Szymon423/Air-Quality-Sensor/01_Hardware/README.md

# Hardware | Air Quality Sensor

| Folder | Contents |
|---|---|
| [`02_KiCad/air-quality-sensor`](02_KiCad/air-quality-sensor) | KiCad 10 project: schematic sheets (`mcu`, `sensors`, `led-ring`, `power-section`) and PCB |
| [`02_KiCad/air-quality-sensor/production`](02_KiCad/air-quality-sensor/production) | JLCPCB fabrication output: Gerbers, BOM, pick & place |
| [`02_KiCad/lib`](02_KiCad/lib) | Project-specific libraries and 3D models |
| [`03_3D_Model/3D-Printing`](03_3D_Model/3D-Printing) | Enclosure parts for 3D printing |

A PDF of the schematic is in [`docs/schematic.pdf`](../docs/schematic.pdf).

Licensed under [CC BY-NC-SA 4.0](../LICENSE).
