Szymon423/Air-Quality-Sensor/02_Software/README.md

# Software | Air Quality Sensor

🚧 Firmware for the ESP32-S3 is not written yet.

Planned:
- Readout of SCD41 (CO₂), SHT4x (temperature / humidity) and SPA06-003 (pressure) over I²C
- Air-quality indication on the 16× WS2812 LED ring
- Wi-Fi connectivity and Home Assistant integration (ESPHome / MQTT)

Licensed under [GPL-3.0](LICENSE).
