Szymon423/Air-Quality-Sensor/docs/images/pcb-top.webp

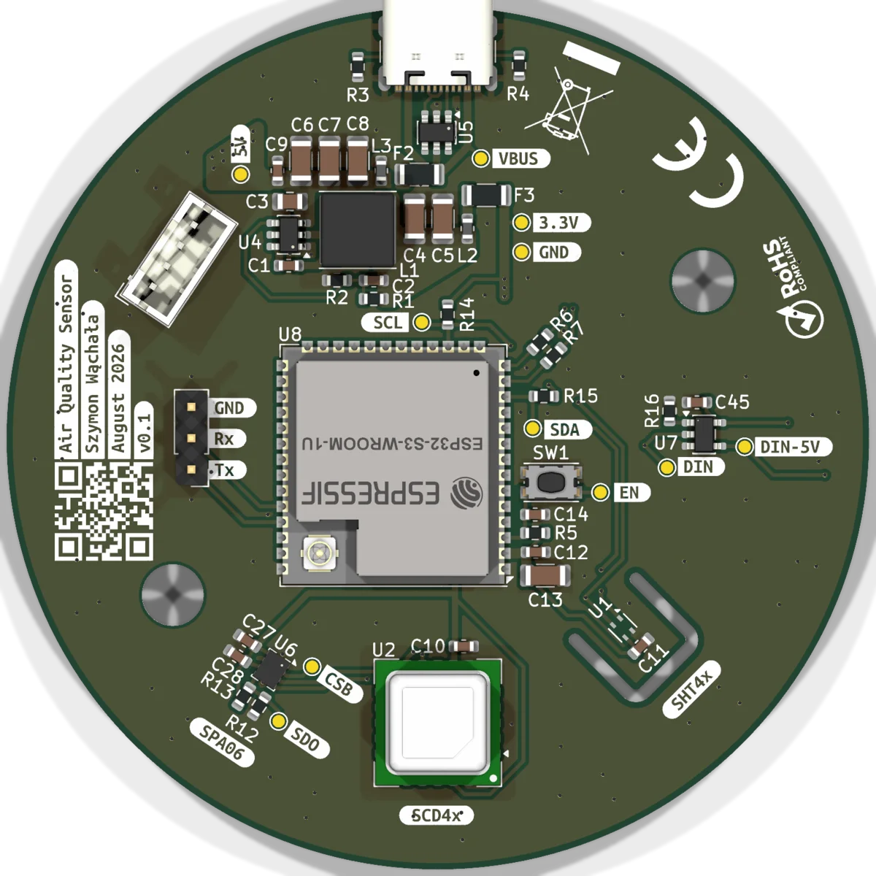
docs/images/pcb-top.webp
