Szymon423/Air-Quality-Sensor/01_Hardware/02_KiCad/air-quality-sensor/production/bom.csv

Designator | Footprint | Quantity | Value | LCSC Part #
C1, C10, C11, C12, C14, C27, C28, C29, C30, C31, C32, C33, C34, C35, C36, C37, C38, C39, C40, C41, C42, C43, C44, C45, C9 | 0603 | 25 | 100n | C14663
C13, C4, C5 | 1206 | 3 | 47u | C96123
C2 | 0603 | 1 | 82p | C1683
C3 | 0805 | 1 | 4.7u | C1779
C6, C7, C8 | 1206 | 3 | 10u | C13585
D10, D11, D12, D13, D14, D15, D16, D17, D18, D19, D4, D5, D6, D7, D8, D9 | LED_WS2812B-2020_PLCC4_2.0x2.0mm | 16 | WS2812C-2020 | C2976072
F2, F3 | 1206 | 2 | 1A | C561579
J1 | USB_C_Receptacle_GCT_USB4105-xx-A_16P_TopMnt_Horizontal | 1 | USB_C_Receptacle_USB2.0_16P | C3020560
L1 | L_APV_ANR6045 | 1 | 10u | C354632
L2, L3 | 0603 | 2 | L_Ferrite | C14709
R1 | 0603 | 1 | 100k | C25803
R13 | 0603 | 1 | 0R | C21189
R14, R15 | 0603 | 2 | 4.7k | C23162
R16 | 0603 | 1 | 0R
R2 | 0603 | 1 | 22k | C31850
R3, R4 | 0603 | 2 | 5.1k | C23186
R5 | 0603 | 1 | 10k | C22369937
R6, R7 | 0603 | 2 | 22R | C23345
SW1 | SW_Push_1P1T_NO_CK_KMR2 | 1 | SW_SPST | C72443
U1 | Sensirion_DFN-4_1.5x1.5mm_P0.8mm_SHT4x_NoCentralPad | 1 | SHT4x | C7461862
U2 | Sensirion_SCD4x-1EP_10.1x10.1mm_P1.25mm_EP4.8x4.8mm | 1 | SCD41-D-R2 | C3037696
U4 | SOT-23-6 | 1 | TPS54302 | C129370
U5 | SOT-23-6 | 1 | USBLC6-2SC6 | C558442
U6 | Bosch_LGA-8_2x2.5mm_P0.65mm_ClockwisePinNumbering | 1 | SPA06-003 | C30589048
U7 | SOT-23-5 | 1 | 74AHCT1G125 | C52140417
U8 | ESP32-S3-WROOM-1U | 1 | ESP32-S3-WROOM-1 | C2980297
