Szymon423/Air-Quality-Sensor/01_Hardware/03_3D_Model/3D-Printing/top.stl

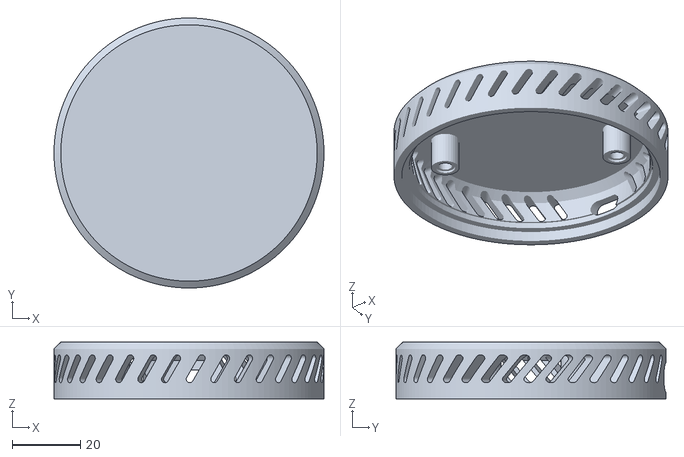
[picture p7: CAD file, 2026-10-19]
01_Hardware/03_3D_Model/3D-Printing/top.stl
79.3 x 79.3 x 16.7
