Szymon423/Air-Quality-Sensor/01_Hardware/03_3D_Model/3D-Printing/enclosure-test.3mf

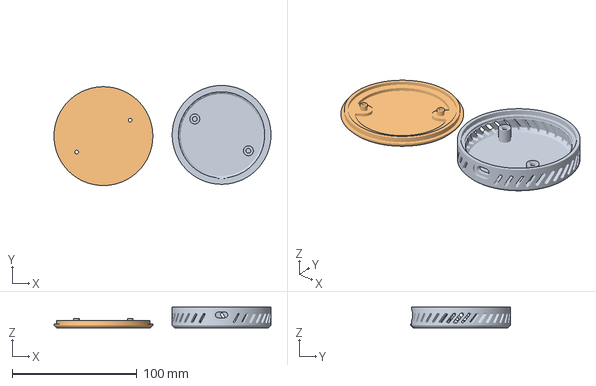
[picture p9: CAD file, 2026-10-19]
01_Hardware/03_3D_Model/3D-Printing/enclosure-test.3mf
174.1 x 80.3 x 16.7 mm
top.stl
btm.stl
