Szymon423/Air-Quality-Sensor/(list of files, cad)

Other CAD files:
01_Hardware/03_3D_Model/test.blend
