Szymon423/Air-Quality-Sensor/docs/schematic.pdf

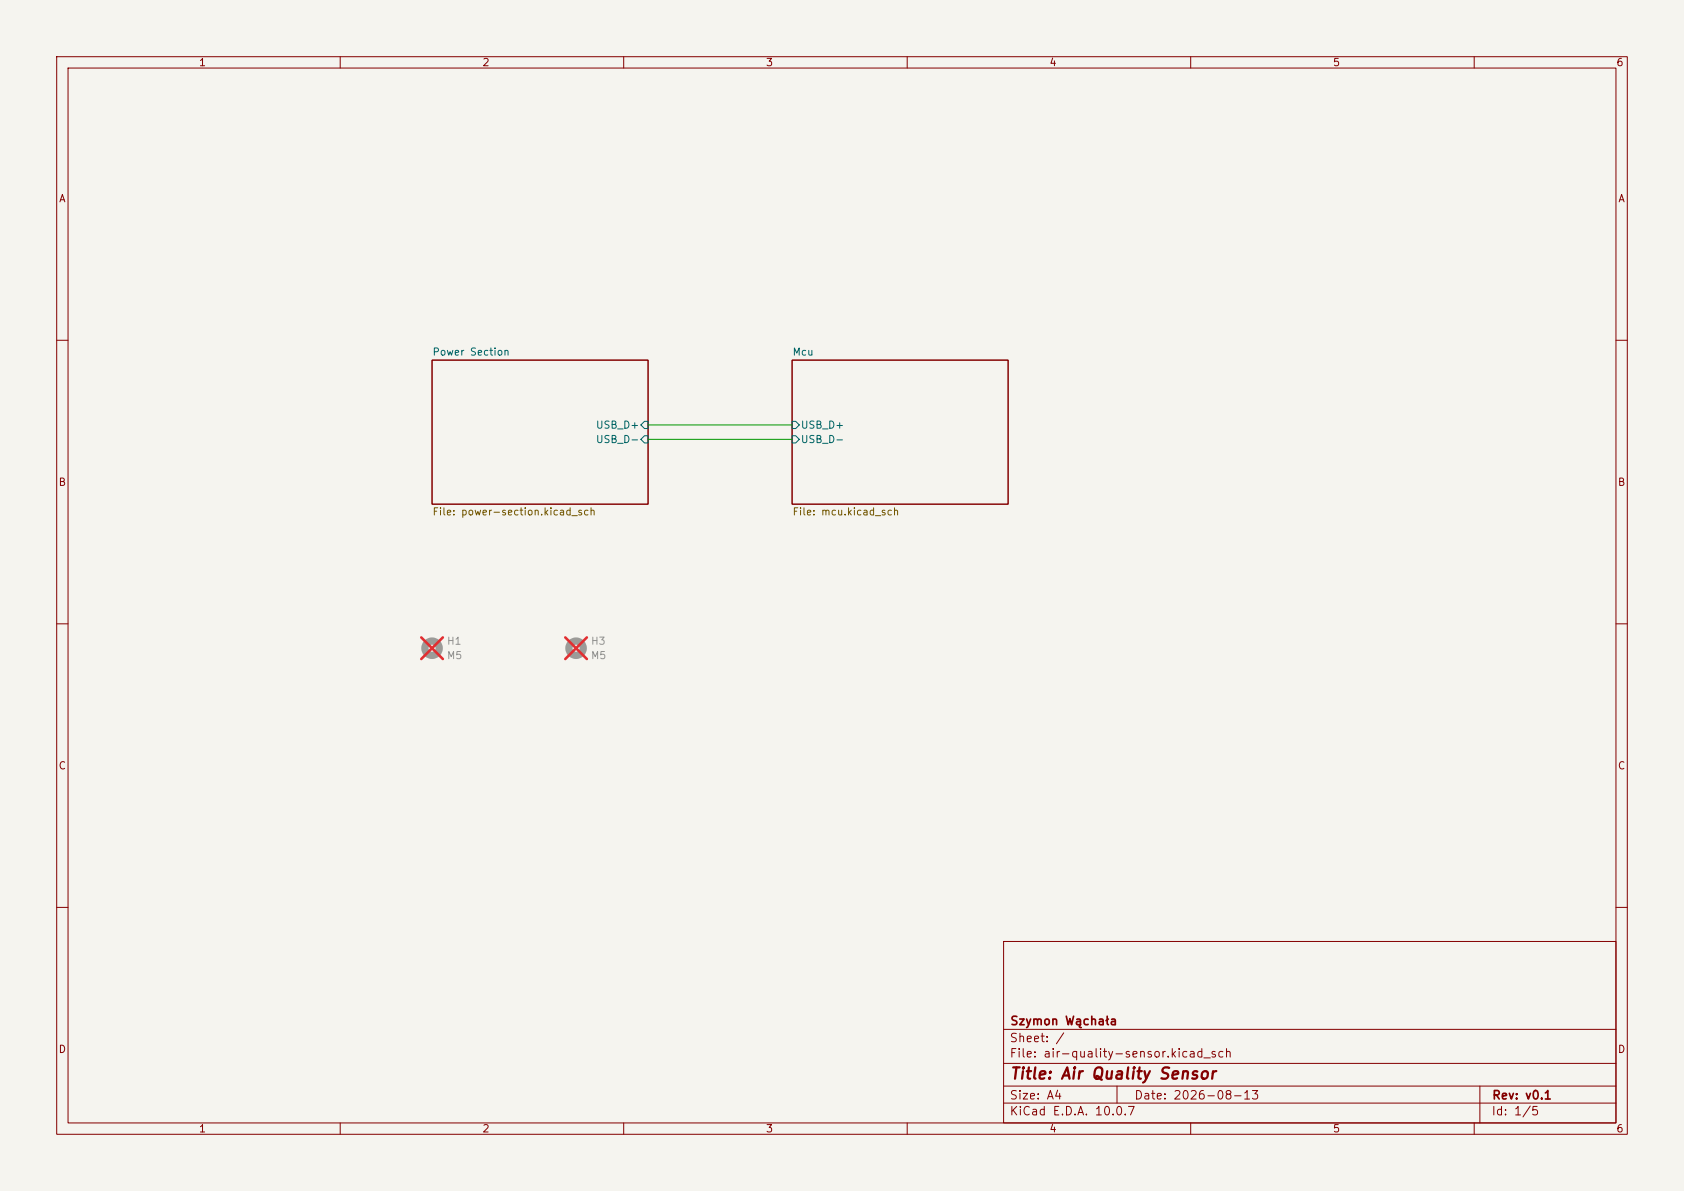
[picture p10: page 1]

Szymon Wąchała
Sheet: /
File: air-quality-sensor.kicad_sch
Title: Air Quality Sensor

Size: A4 | Rev: v0.1
KiCad E.D.A. 10.0.7 | Id: 1/5

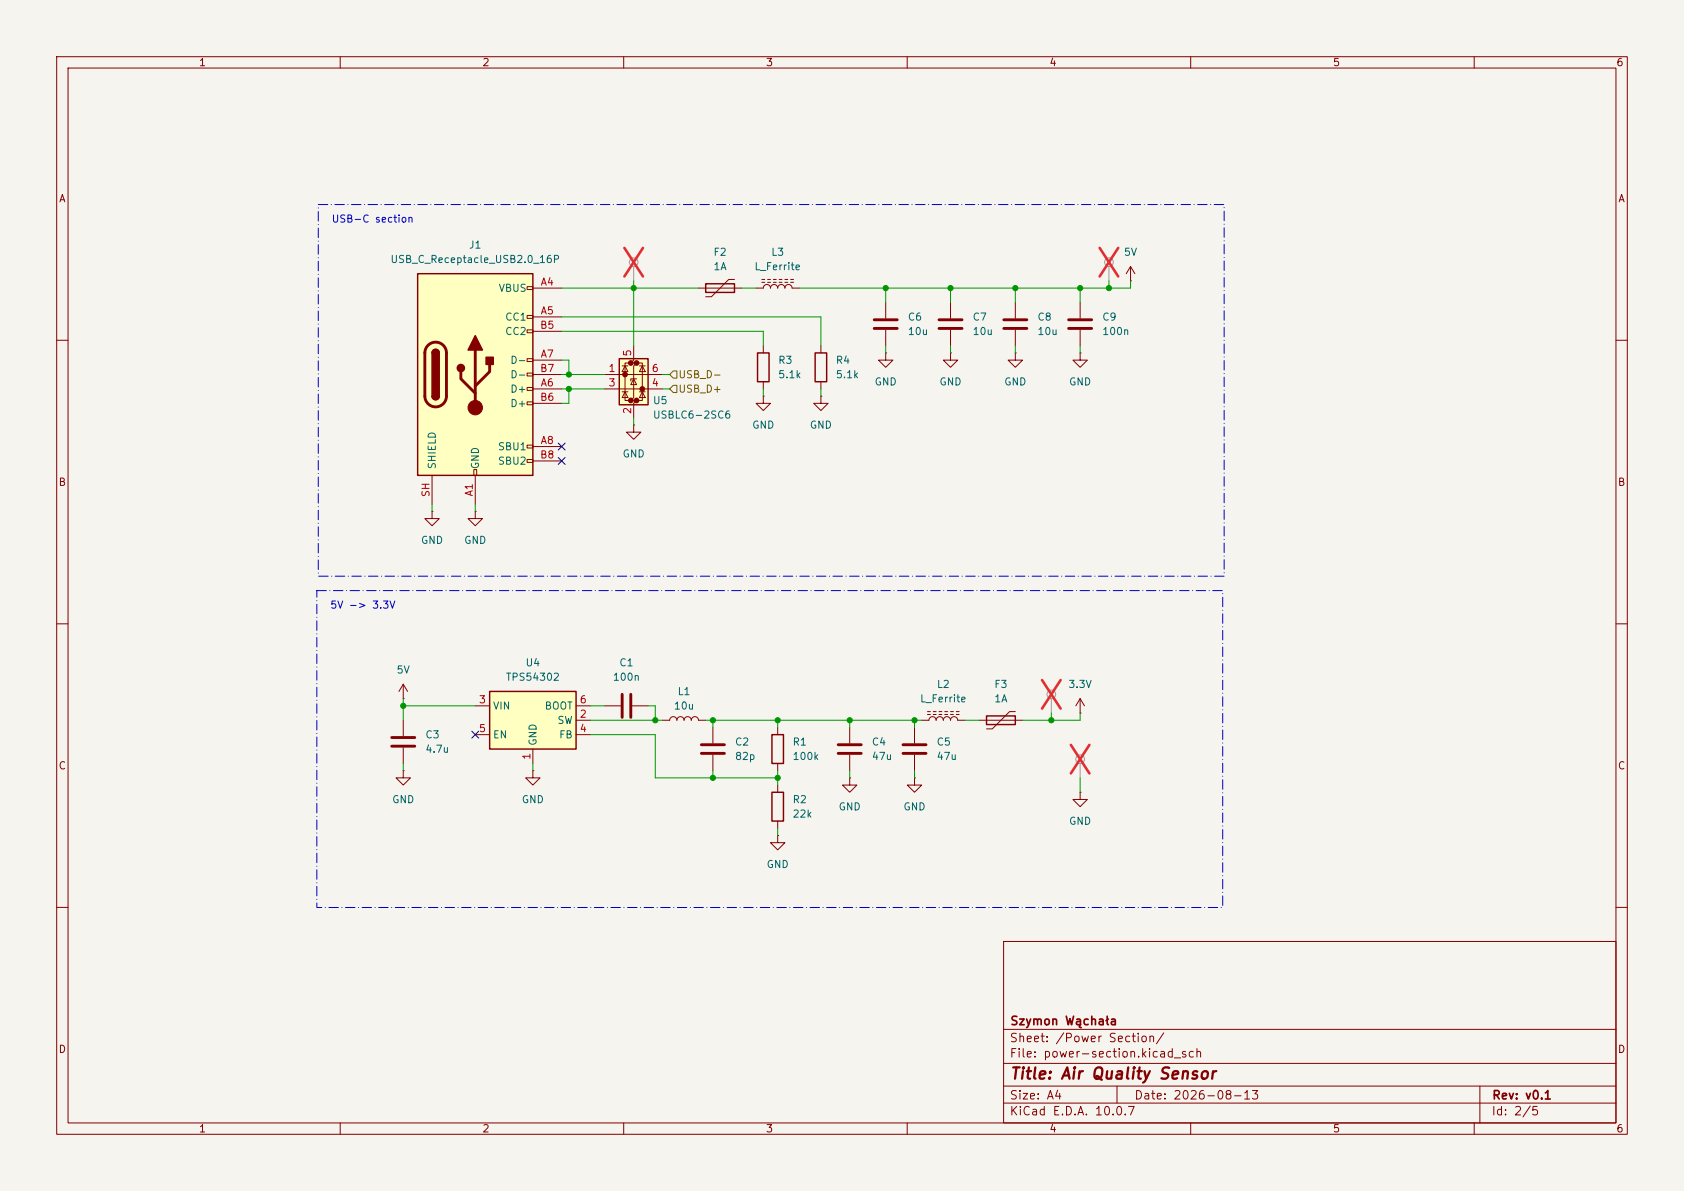
[picture p11: page 2]

Szymon Wąchała
Sheet: /Power Section/
File: power-section.kicad_sch
Title: Air Quality Sensor

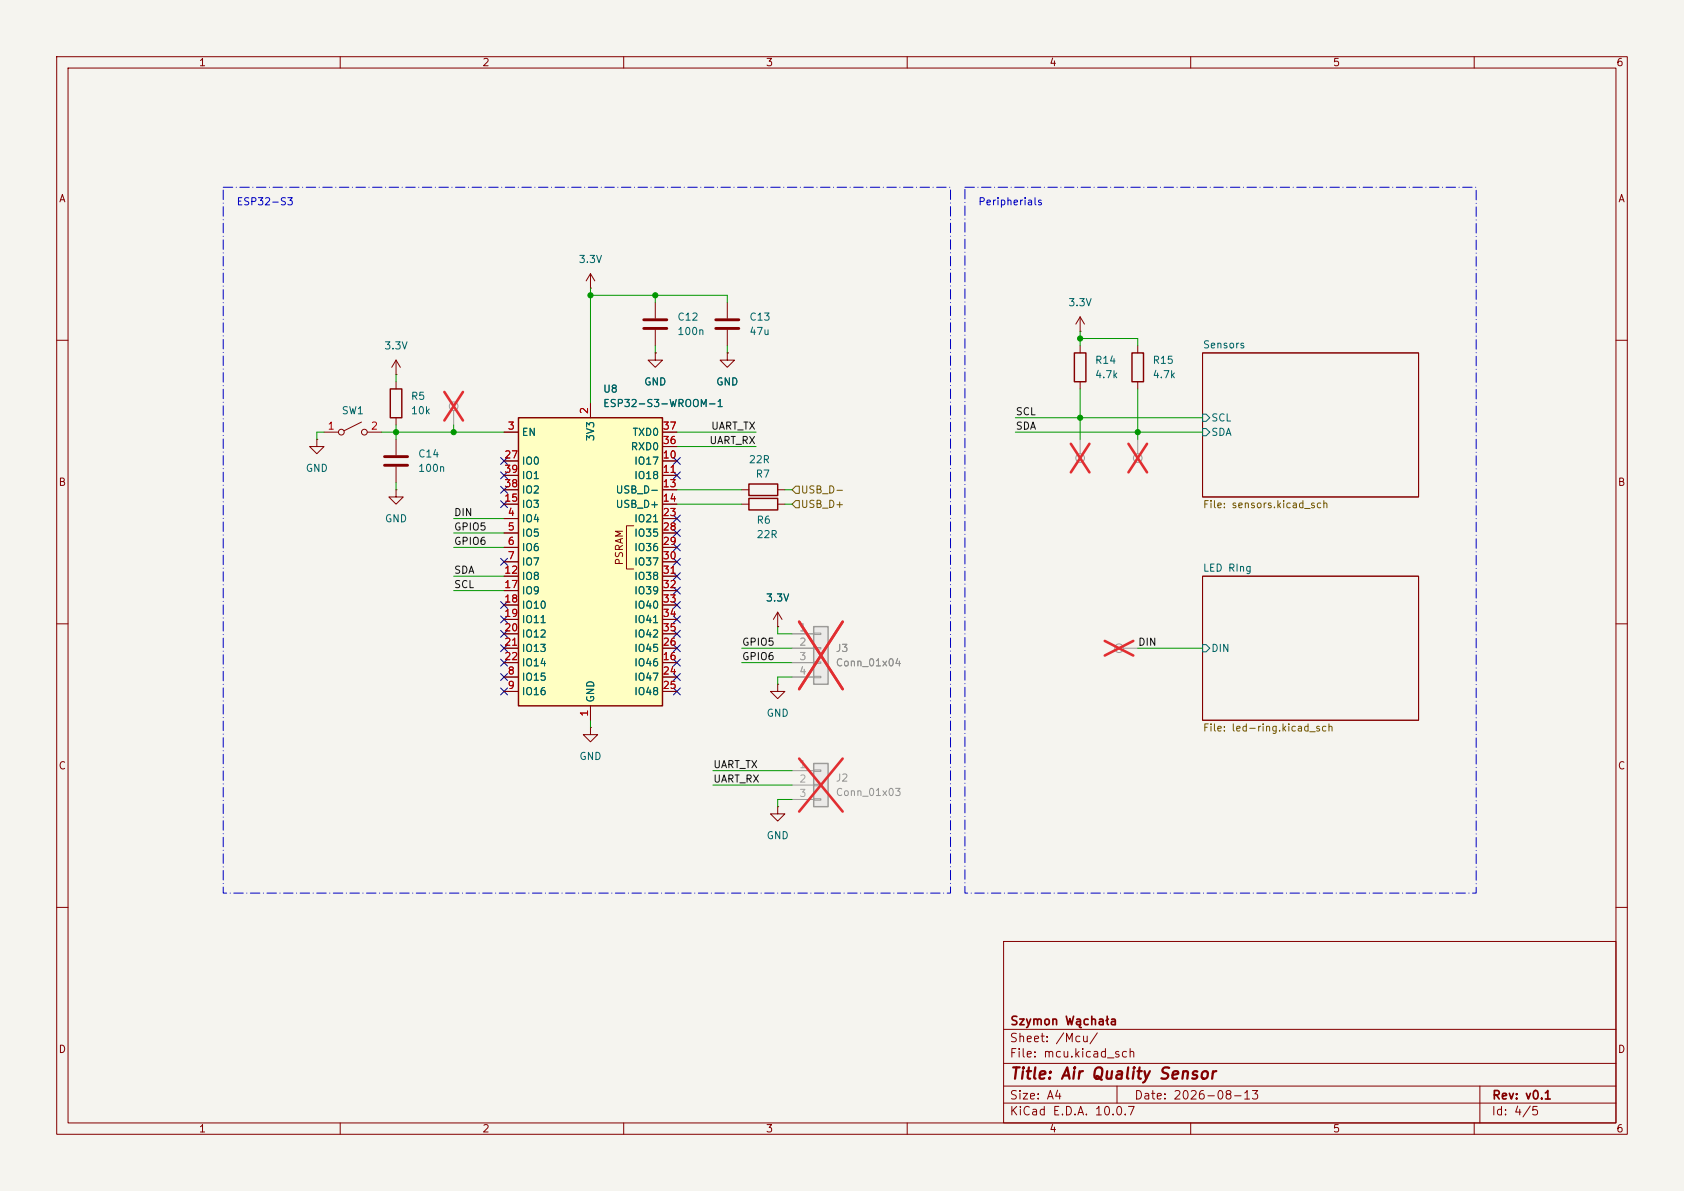
[picture p12: page 3]

File: led-ring.kicad_sch SCL SDA Sensors File: sensors.kicad_sch R6
IO42 35 RXD0 36 TXD0 37

Szymon Wąchała
Sheet: /Mcu/
File: mcu.kicad_sch
Title: Air Quality Sensor

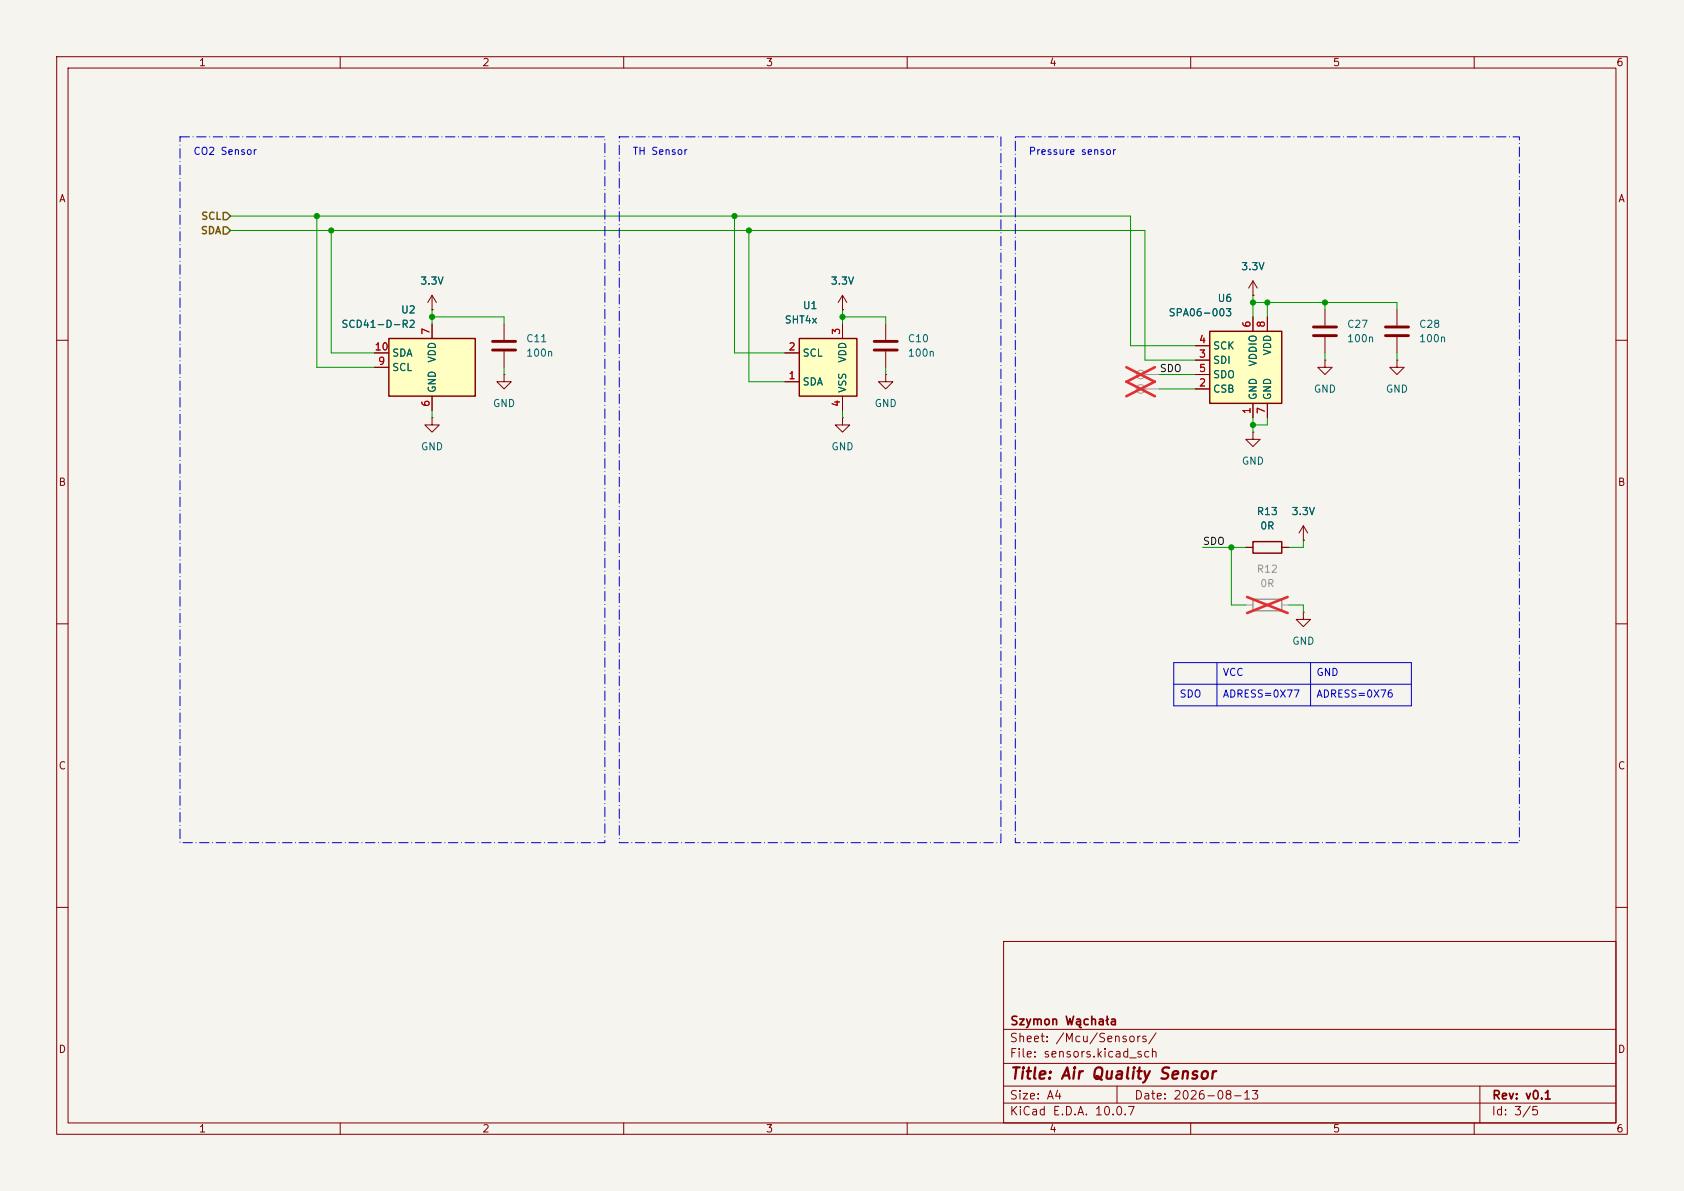
[picture p13: page 4]

VCC | GND

SDO | ADRESS=0X77 | ADRESS=0X76

Szymon Wąchała
Sheet: /Mcu/Sensors/
File: sensors.kicad_sch
Title: Air Quality Sensor

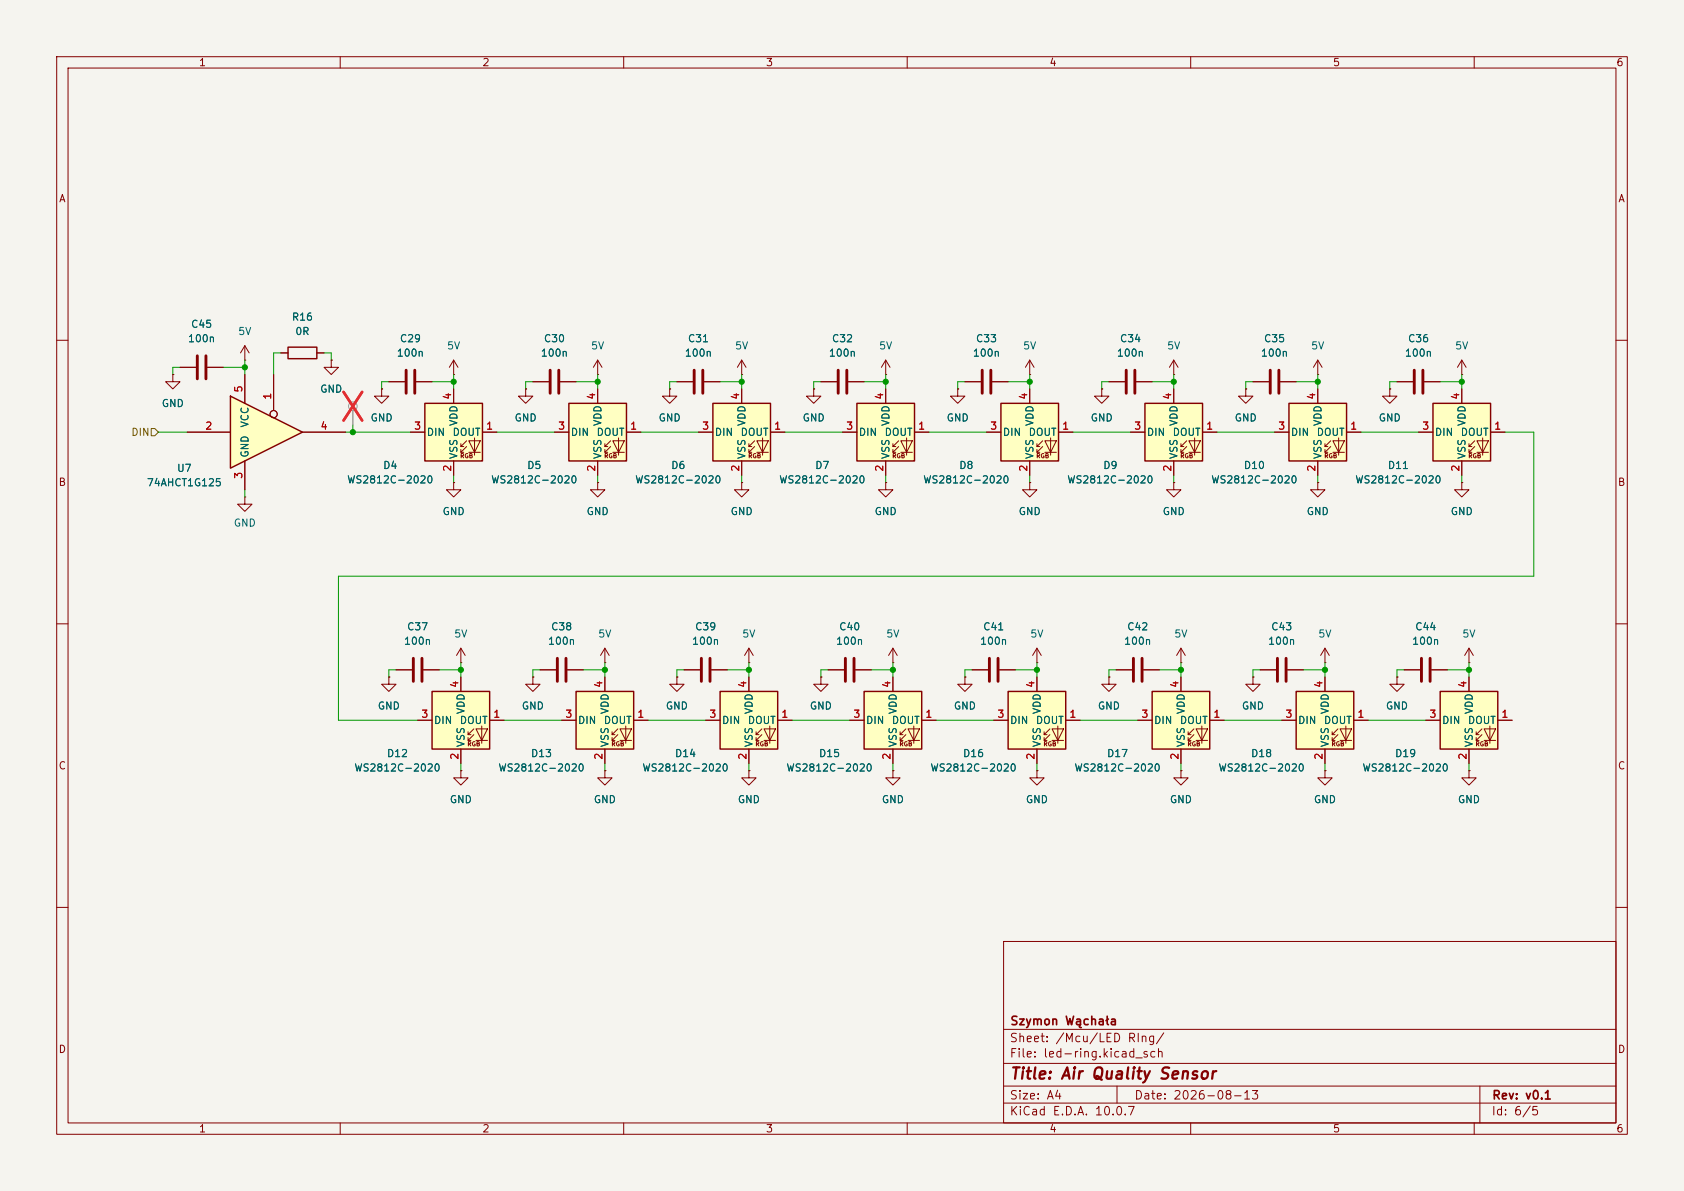
[picture p14: page 5]

Szymon Wąchała
Sheet: /Mcu/LED RIng/
File: led-ring.kicad_sch
Title: Air Quality Sensor
