Szymon423/Air-Quality-Sensor/01_Hardware/02_KiCad/air-quality-sensor/air-quality-sensor.kicad_pcb

## KiCad design 01_Hardware/02_KiCad/air-quality-sensor/air-quality-sensor.kicad_pcb (2026-08-15)

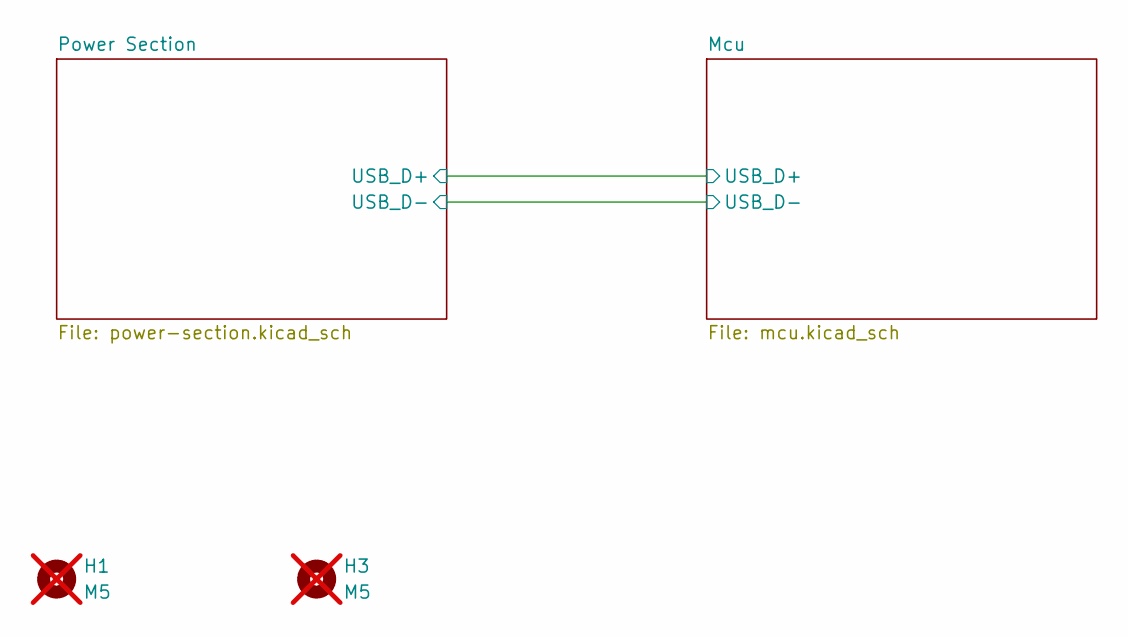
[picture p15: schematic air-quality-sensor.kicad_sch, Air Quality Sensor]

Parts:
H1, H3: M5; MountingHole_5mm; not fitted

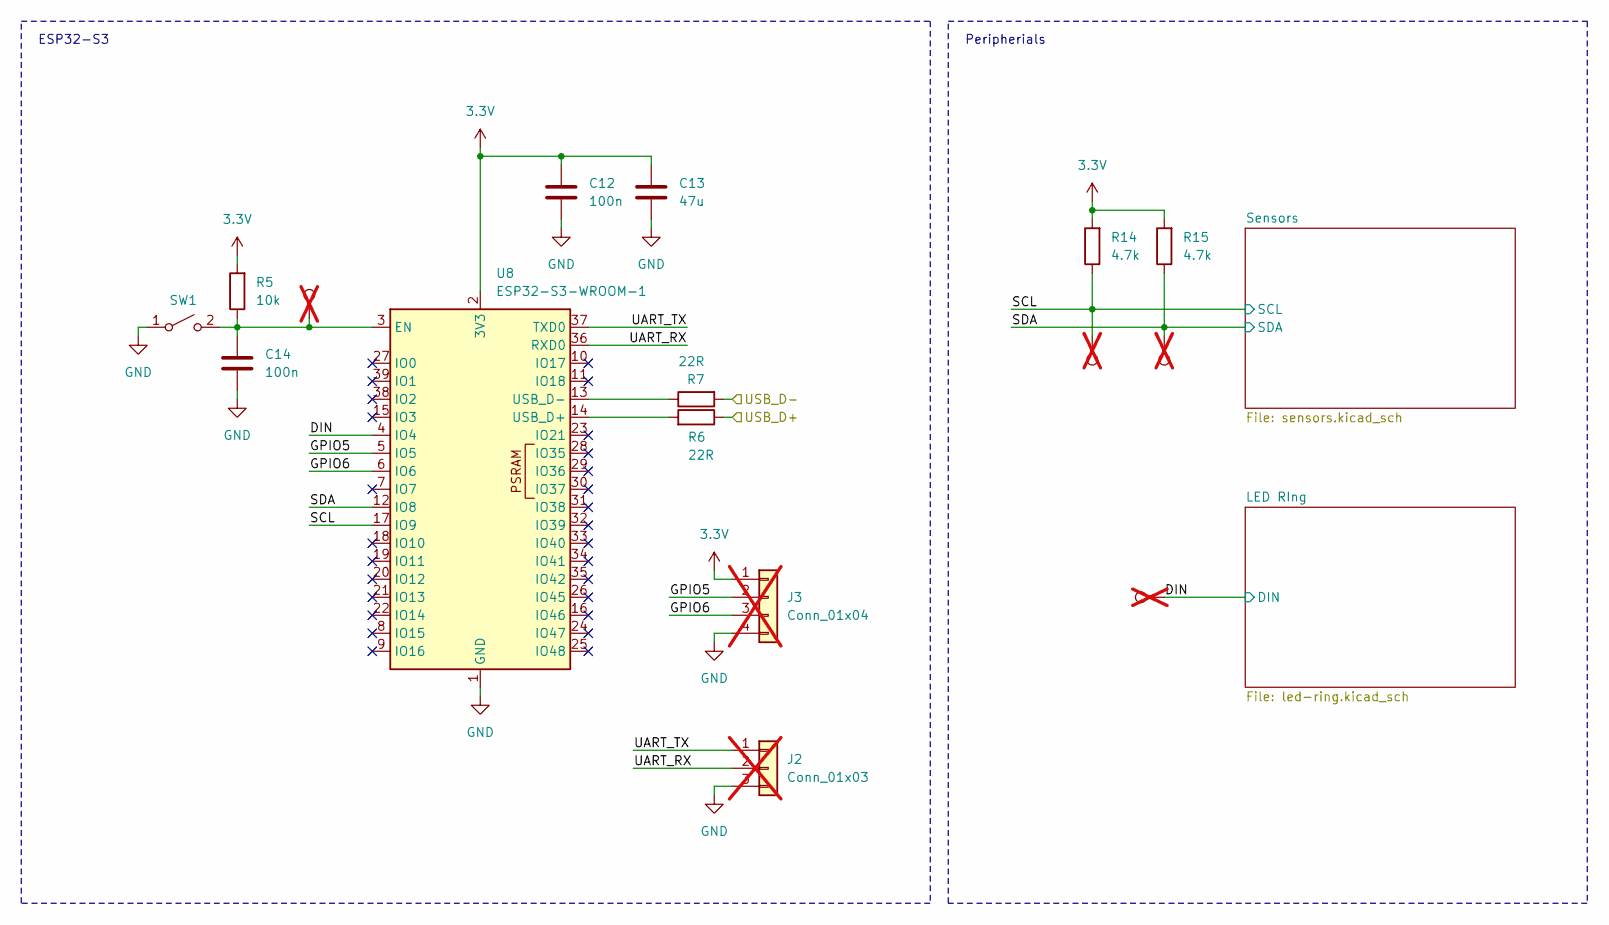
[picture p16: schematic mcu.kicad_sch, Air Quality Sensor]

Parts:
C12, C14: 100n; C_0603_1608Metric; LCSC C14663
C13: 47u; C_1206_3216Metric; LCSC C96123
J2: Conn_01x03; PinHeader_1x03_P2.54mm_Vertical; not fitted
J3: Conn_01x04; JST_PH_B4B-PH-K_1x04_P2.00mm_Vertical; not fitted
R5: 10k; R_0603_1608Metric; LCSC C22369937
R6, R7: 22R; R_0603_1608Metric; LCSC C23345
R14, R15: 4.7k; R_0603_1608Metric; LCSC C23162
SW1: SW_SPST; SW_Push_1P1T_NO_CK_KMR2; LCSC C72443
TP4, TP5, TP6, TP9: 3.3V; TestPoint_Pad_D1.0mm; not fitted
U8: ESP32-S3-WROOM-1; ESP32-S3-WROOM-1U; LCSC C2980297

Connections:
3.3V: C12.2, C13.1, J3.1, R5.2, R14.2, R15.2, U8.2 (3V3); also elsewhere on the board
/Mcu/DIN: TP9.1 (1_1), U8.4 (IO4); also elsewhere on the board
/Mcu/GPIO5: J3.2, U8.5 (IO5)
/Mcu/GPIO6: J3.3, U8.6 (IO6)
/Mcu/SCL: R14.1, TP5.1 (1_1), U8.17 (IO9); also elsewhere on the board
/Mcu/SDA: R15.1, TP4.1 (1_1), U8.12 (IO8); also elsewhere on the board
/Mcu/UART_RX: J2.2, U8.36 (RXD0)
/Mcu/UART_TX: J2.1, U8.37 (TXD0)
/Mcu/USB_D+: R6.1; also elsewhere on the board
/Mcu/USB_D-: R7.2; also elsewhere on the board
GND: C12.1, C13.2, C14.1, J2.3, J3.4, SW1.1 (A), U8.1 (GND), U8.40 (GND), U8.41 (GND); also elsewhere on the board
unnamed: C14.2, R5.1, SW1.2 (B), TP6.1 (1_1), U8.3 (EN)
unnamed: R6.2, U8.14 (USB_D+)
unnamed: R7.1, U8.13 (USB_D-)

Notes on the sheet:
ESP32-S3
Peripherials

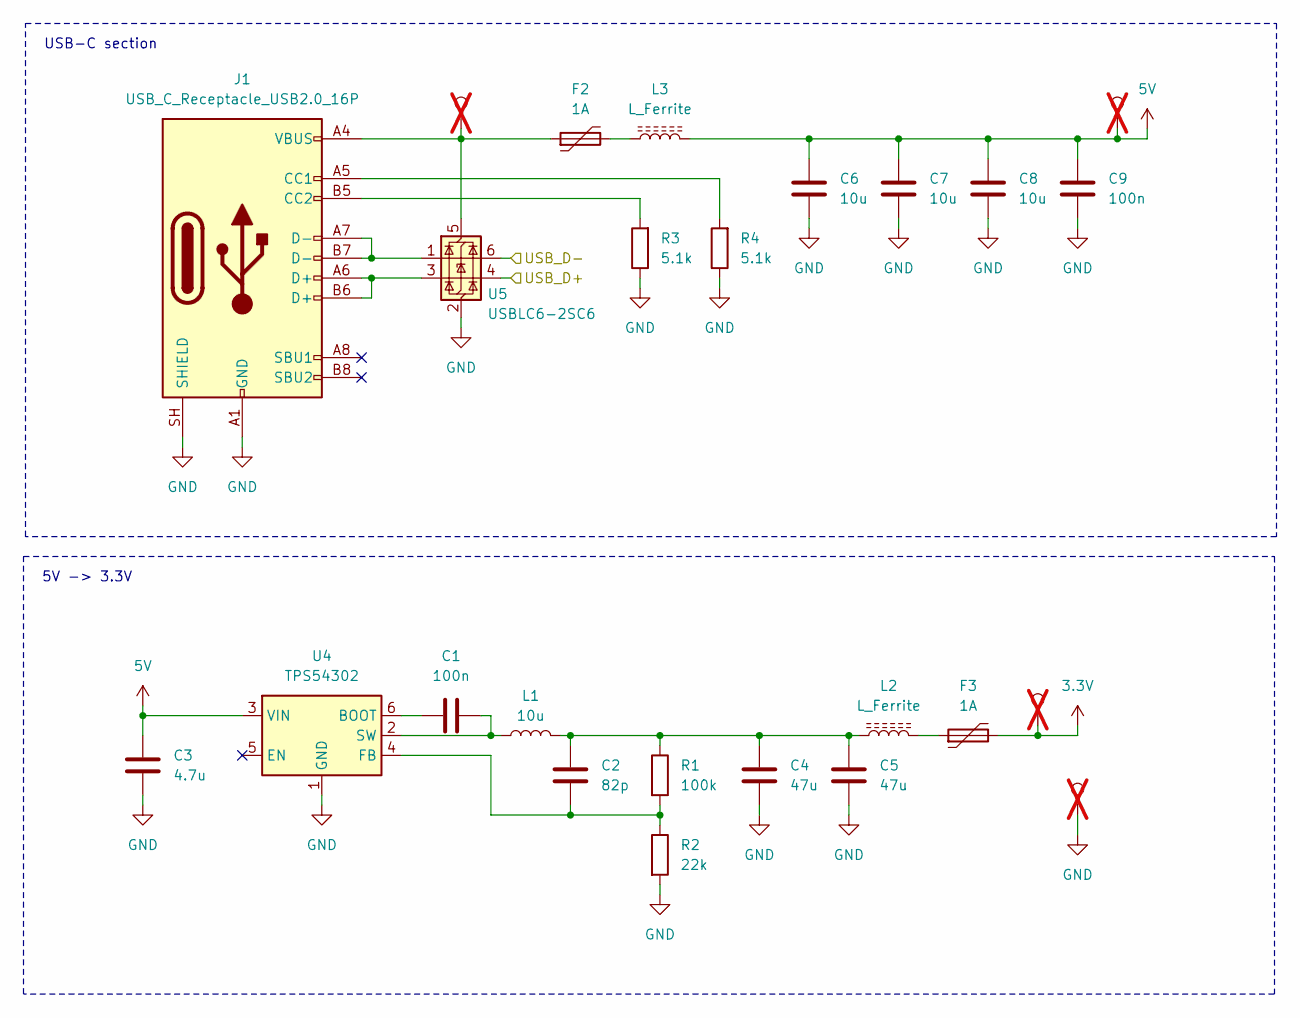
[picture p17: schematic power-section.kicad_sch, Air Quality Sensor]

Parts:
C1, C9: 100n; C_0603_1608Metric; LCSC C14663
C2: 82p; C_0603_1608Metric; LCSC C1683
C3: 4.7u; C_0805_2012Metric; LCSC C1779
C4, C5: 47u; C_1206_3216Metric; LCSC C96123
C6, C7, C8: 10u; C_1206_3216Metric; LCSC C13585
F2, F3: 1A; R_1206_3216Metric; LCSC C561579
J1: USB_C_Receptacle_USB2.0_16P; USB_C_Receptacle_GCT_USB4105-xx-A_16P_TopMnt_Horizontal; LCSC C3020560
L1: 10u; L_APV_ANR6045; LCSC C354632
L2, L3: L_Ferrite; L_0603_1608Metric; LCSC C14709
R1: 100k; R_0603_1608Metric; LCSC C25803
R2: 22k; R_0603_1608Metric; LCSC C31850
R3, R4: 5.1k; R_0603_1608Metric; LCSC C23186
TP1, TP2, TP3, TP10: 3.3V; TestPoint_Pad_D1.0mm; not fitted
U4: TPS54302; SOT-23-6; LCSC C129370
U5: USBLC6-2SC6; SOT-23-6; LCSC C558442

Connections:
3.3V: F3.2, TP1.1 (1_1); also elsewhere on the board
5V: C3.1, C6.1, C7.1, C8.1, C9.2, L3.2, TP2.1 (1_1), U4.3 (VIN); also elsewhere on the board
/Mcu/USB_D+: U5.4 (I/O2); also elsewhere on the board
/Mcu/USB_D-: U5.6 (I/O1); also elsewhere on the board
GND: C3.2, C4.2, C5.2, C6.2, C7.2, C8.2, C9.1, J1.A1 (GND), J1.A12 (GND), J1.B1 (GND), J1.B12 (GND), J1.SH (SHIELD), R2.2, R3.1, R4.1, TP10.1 (1_1), U4.1 (GND), U5.2 (GND); also elsewhere on the board
unnamed: C2.2, C4.1, C5.1, L1.2, L2.1, R1.1
unnamed: F2.2, L3.1
unnamed: F3.1, L2.2
unnamed: J1.A5 (CC1), R4.2
unnamed: J1.B5 (CC2), R3.2
unnamed: J1.A6 (D+), J1.B6 (D+), U5.3 (I/O2)
unnamed: J1.A7 (D-), J1.B7 (D-), U5.1 (I/O1)
unnamed: C1.1, U4.6 (BOOT)
unnamed: C2.1, R1.2, R2.1, U4.4 (FB)
unnamed: C1.2, L1.1, U4.2 (SW)
unnamed: F2.1, J1.A4 (VBUS), J1.A9 (VBUS), J1.B4 (VBUS), J1.B9 (VBUS), TP3.1 (1_1), U5.5 (VBUS)

Notes on the sheet:
5V -> 3.3V
USB-C section

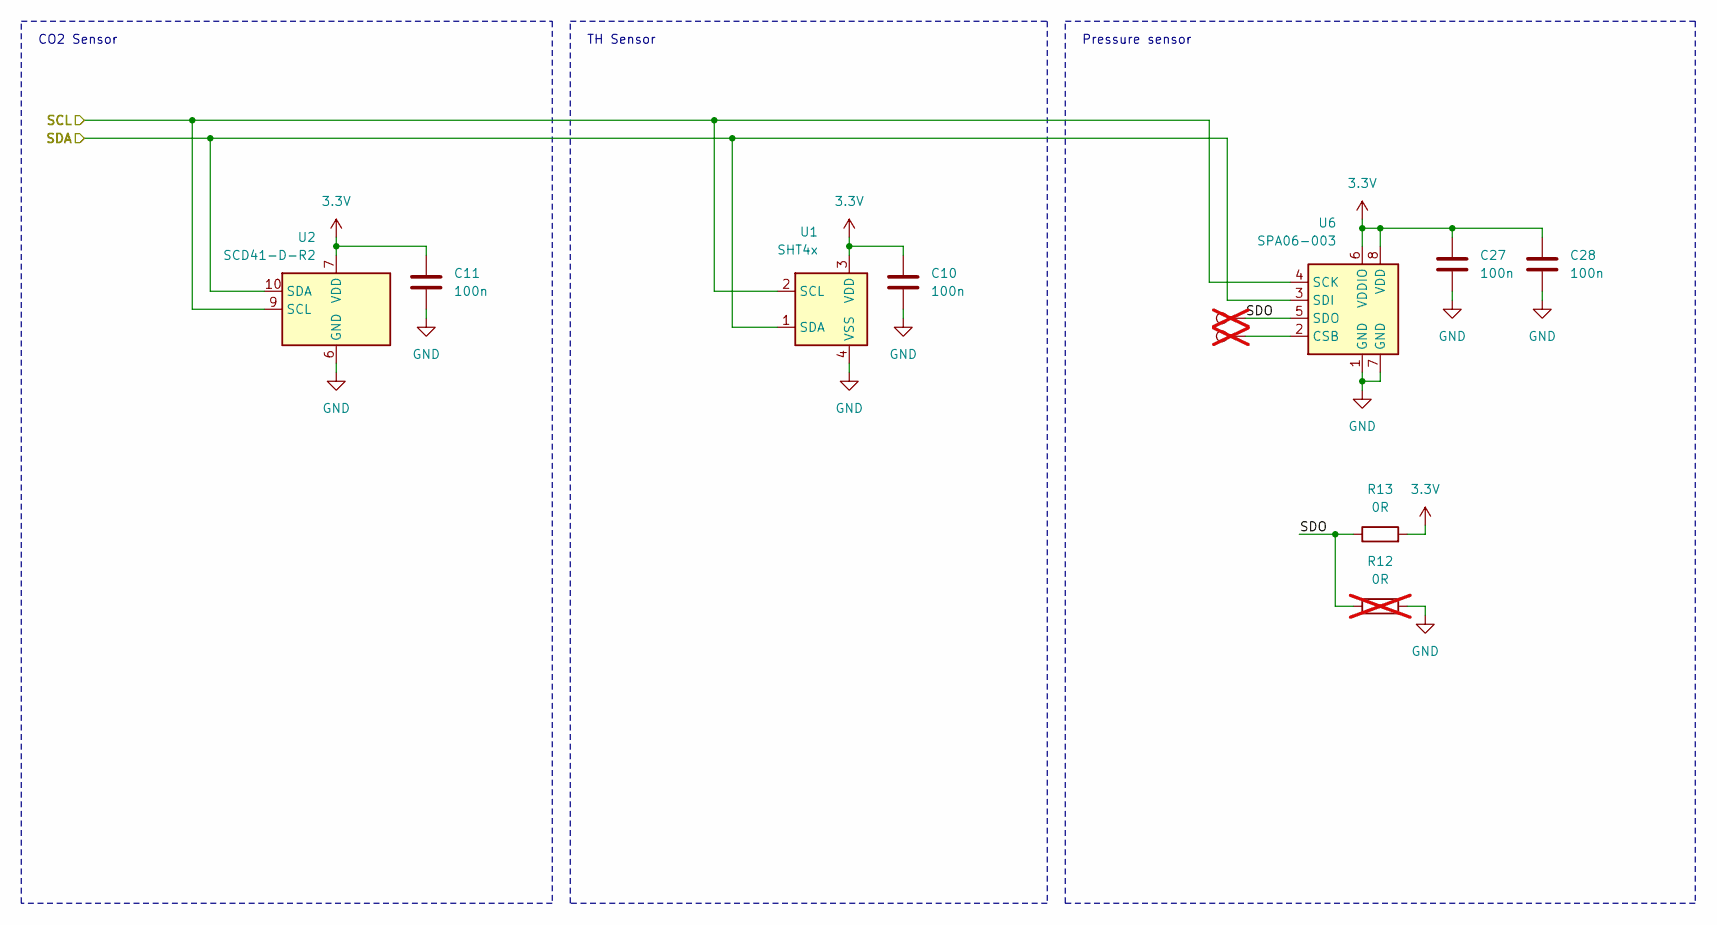
[picture p18: schematic sensors.kicad_sch, Air Quality Sensor]

Parts:
C10, C11, C27, C28: 100n; C_0603_1608Metric; LCSC C14663
R12: 0R; R_0603_1608Metric; LCSC C21189; not fitted
R13: 0R; R_0603_1608Metric; LCSC C21189
TP7, TP8: 3.3V; TestPoint_Pad_D1.0mm; not fitted
U1: SHT4x; Sensirion_DFN-4_1.5x1.5mm_P0.8mm_SHT4x_NoCentralPad; LCSC C7461862
U2: SCD41-D-R2; Sensirion_SCD4x-1EP_10.1x10.1mm_P1.25mm_EP4.8x4.8mm; LCSC C3037696
U6: SPA06-003; Bosch_LGA-8_2x2.5mm_P0.65mm_ClockwisePinNumbering; LCSC C30589048

Connections:
3.3V: C10.2, C11.2, C27.1, C28.1, R13.2, U1.3 (VDD), U2.7 (VDD), U2.19 (VDD), U6.6 (VDDIO), U6.8 (VDD); also elsewhere on the board
/Mcu/SCL: U1.2 (SCL), U2.9 (SCL), U6.4 (SCK); also elsewhere on the board
/Mcu/SDA: U1.1 (SDA), U2.10 (SDA), U6.3 (SDI); also elsewhere on the board
/Mcu/Sensors/SDO: R12.1, R13.1, TP7.1 (1_1), U6.5 (SDO)
GND: C10.1, C11.1, C27.2, C28.2, R12.2, U1.4 (VSS), U2.6 (GND), U2.20 (GND), U2.21 (GND), U6.1 (GND), U6.7 (GND); also elsewhere on the board
unnamed: TP8.1 (1_1), U6.2 (CSB)

Notes on the sheet:
TH Sensor
CO2 Sensor
Pressure sensor

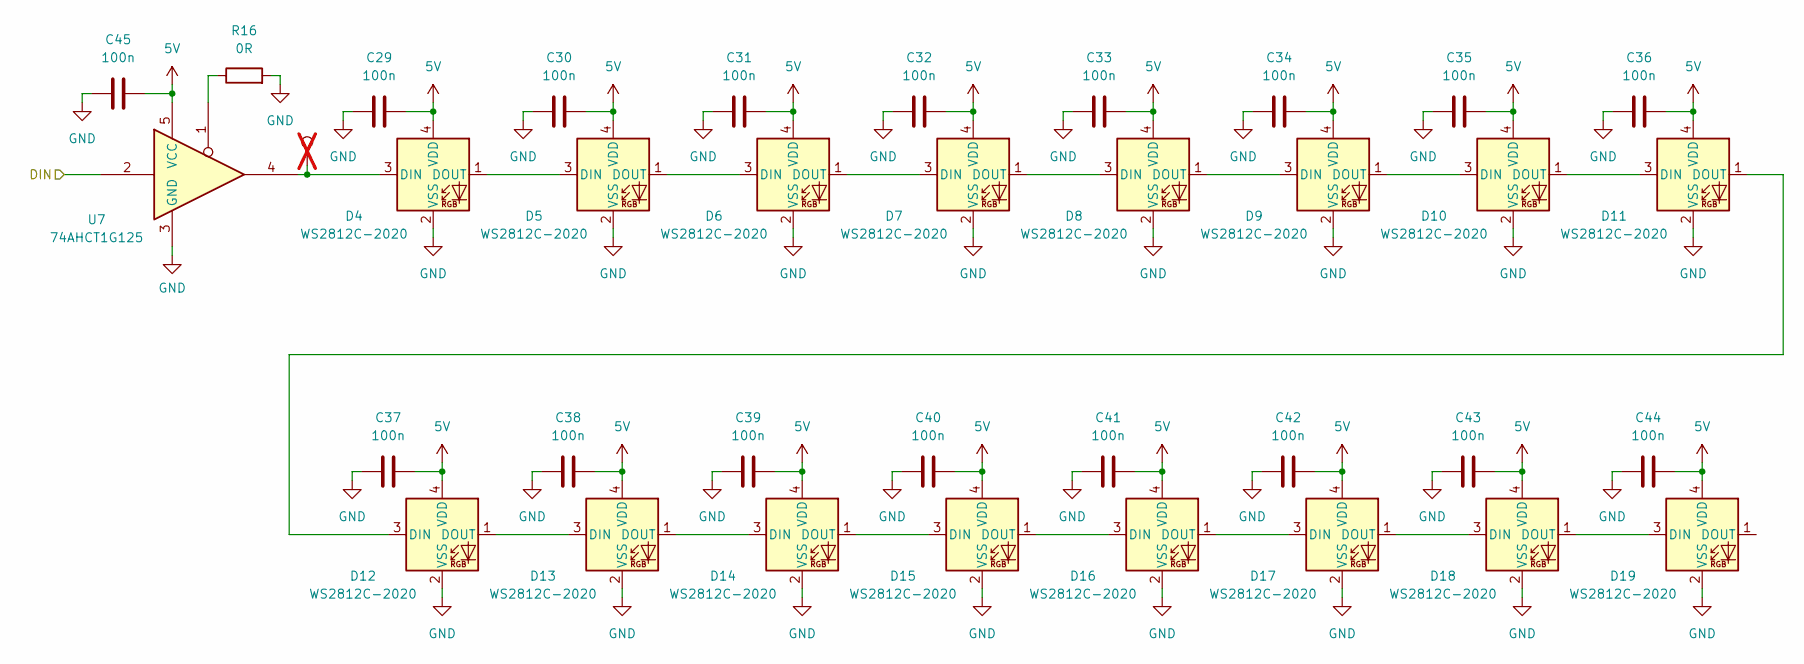
[picture p19: schematic led-ring.kicad_sch, Air Quality Sensor]

Parts:
C29, C30, C31, C32, C33, C34, C35, C36, C37, C38, C39, C40, C41, C42, C43, C44, C45: 100n; C_0603_1608Metric; LCSC C14663
D4, D5, D6, D7, D8, D9, D10, D11, D12, D13, D14, D15, D16, D17, D18, D19: WS2812C-2020; LED_WS2812B-2020_PLCC4_2.0x2.0mm; LCSC C2976072
R16: 0R; R_0603_1608Metric; LCSC C21189
TP19: 3.3V; TestPoint_Pad_D1.0mm; not fitted
U7: 74AHCT1G125; SOT-23-5; LCSC C52140417

Connections:
5V: C29.1, C30.1, C31.1, C32.1, C33.1, C34.1, C35.1, C36.1, C37.1, C38.1, C39.1, C40.1, C41.1, C42.1, C43.1, C44.1, C45.1, D4.4 (VDD), D5.4 (VDD), D6.4 (VDD), D7.4 (VDD), D8.4 (VDD), D9.4 (VDD), D10.4 (VDD), D11.4 (VDD), D12.4 (VDD), D13.4 (VDD), D14.4 (VDD), D15.4 (VDD), D16.4 (VDD), D17.4 (VDD), D18.4 (VDD), D19.4 (VDD), U7.5 (VCC); also elsewhere on the board
/Mcu/DIN: U7.2; also elsewhere on the board
GND: C29.2, C30.2, C31.2, C32.2, C33.2, C34.2, C35.2, C36.2, C37.2, C38.2, C39.2, C40.2, C41.2, C42.2, C43.2, C44.2, C45.2, D4.2 (VSS), D5.2 (VSS), D6.2 (VSS), D7.2 (VSS), D8.2 (VSS), D9.2 (VSS), D10.2 (VSS), D11.2 (VSS), D12.2 (VSS), D13.2 (VSS), D14.2 (VSS), D15.2 (VSS), D16.2 (VSS), D17.2 (VSS), D18.2 (VSS), D19.2 (VSS), R16.2, U7.3 (GND); also elsewhere on the board
unnamed: D4.3 (DIN), TP19.1 (1_1), U7.4
unnamed: D4.1 (DOUT), D5.3 (DIN)
unnamed: D5.1 (DOUT), D6.3 (DIN)
unnamed: D6.1 (DOUT), D7.3 (DIN)
unnamed: D7.1 (DOUT), D8.3 (DIN)
unnamed: D8.1 (DOUT), D9.3 (DIN)
unnamed: D9.1 (DOUT), D10.3 (DIN)
unnamed: D10.1 (DOUT), D11.3 (DIN)
unnamed: D11.1 (DOUT), D12.3 (DIN)
unnamed: D12.1 (DOUT), D13.3 (DIN)
unnamed: D13.1 (DOUT), D14.3 (DIN)
unnamed: D14.1 (DOUT), D15.3 (DIN)
unnamed: D15.1 (DOUT), D16.3 (DIN)
unnamed: D16.1 (DOUT), D17.3 (DIN)
unnamed: D17.1 (DOUT), D18.3 (DIN)
unnamed: D18.1 (DOUT), D19.3 (DIN)
unnamed: R16.1, U7.1

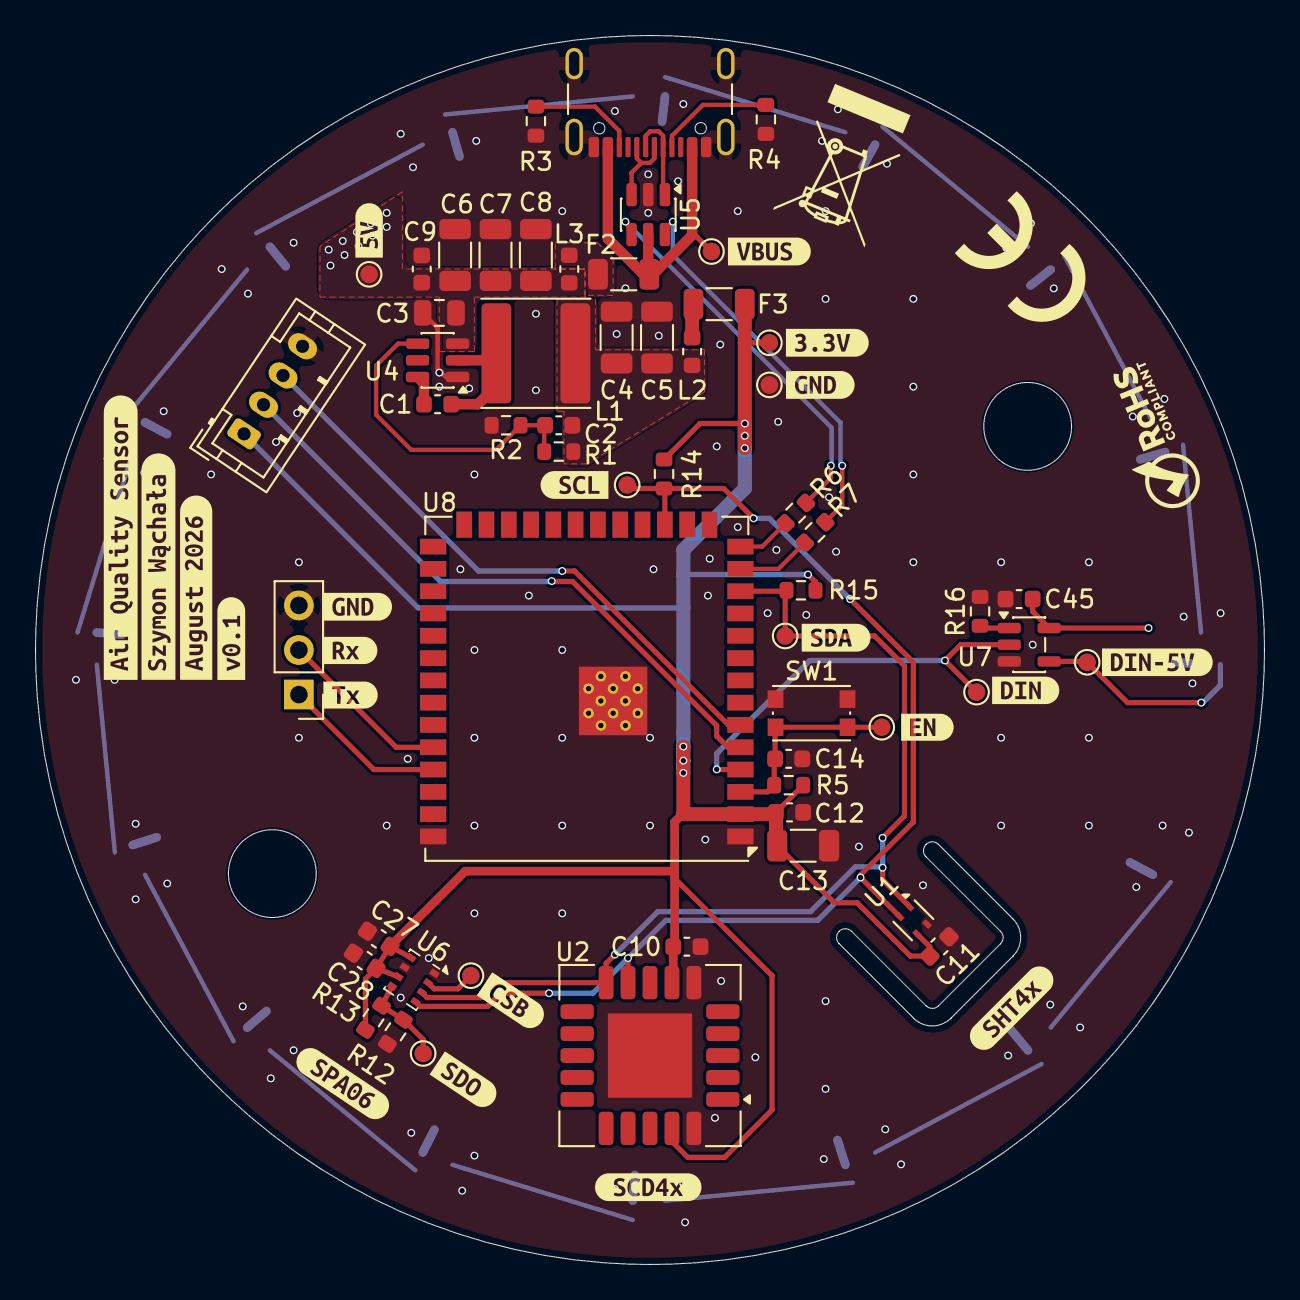
[picture p20: board air-quality-sensor.kicad_pcb from above]

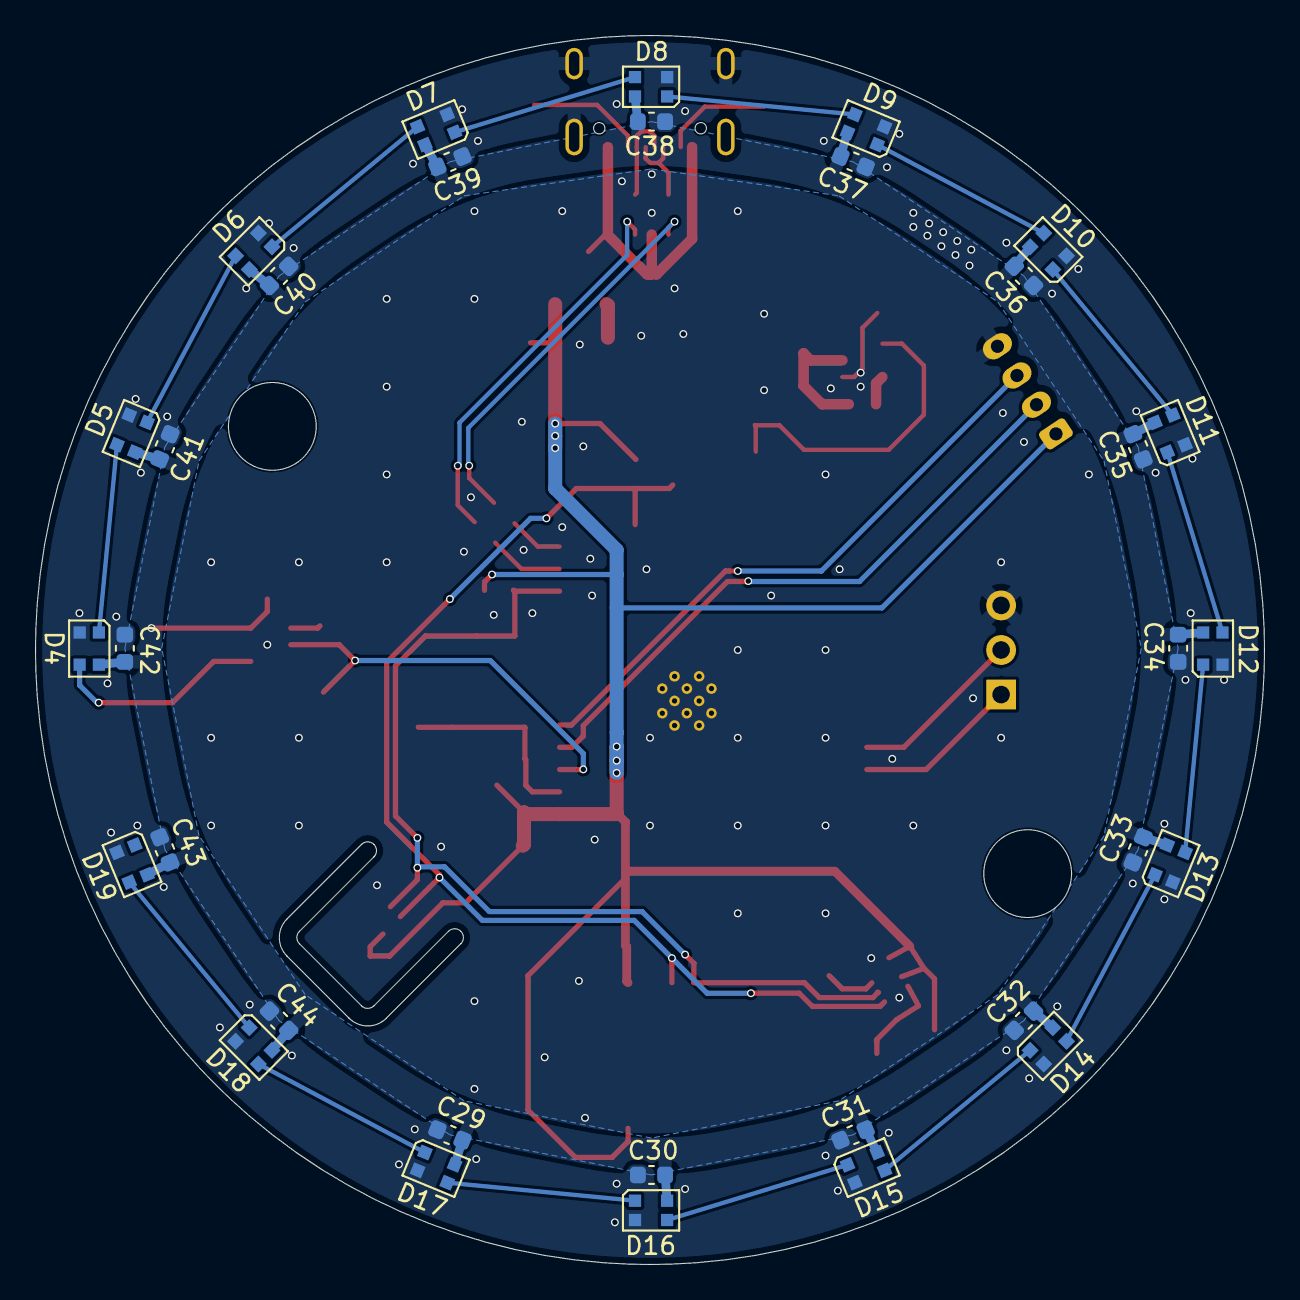
[picture p21: board air-quality-sensor.kicad_pcb from below]

Board: 2 copper layers, 70.0 x 70.0 mm, 111 parts (32 on the bottom side), 45 nets.

Other parts of the board:
kibuzzard-6A7E4C1B: G***; kibuzzard-6A7E4C1B
kibuzzard-6A7E4C16: G***; kibuzzard-6A7E4C16
kibuzzard-6A7E4C25: G***; kibuzzard-6A7E4C25
kibuzzard-6A7E4C33: G***; kibuzzard-6A7E4C33
kibuzzard-6A7E44B1: G***; kibuzzard-6A7E44B1
kibuzzard-6A7E44DD: G***; kibuzzard-6A7E44DD
kibuzzard-6A7E44FE: G***; kibuzzard-6A7E44FE
kibuzzard-6A7E45B3: G***; kibuzzard-6A7E45B3
kibuzzard-6A7E45BF: G***; kibuzzard-6A7E45BF
kibuzzard-6A7E45D0: G***; kibuzzard-6A7E45D0
kibuzzard-6A7E47FA: G***; kibuzzard-6A7E47FA
kibuzzard-6A7E446E: G***; kibuzzard-6A7E446E
kibuzzard-6A7E450C: G***; kibuzzard-6A7E450C
kibuzzard-6A7E453D: G***; kibuzzard-6A7E453D
kibuzzard-6A7E4485: G***; kibuzzard-6A7E4485
kibuzzard-6A7E4494: G***; kibuzzard-6A7E4494
kibuzzard-6A7E4579: G***; kibuzzard-6A7E4579
kibuzzard-6A7E4598: G***; kibuzzard-6A7E4598
kibuzzard-6A80ED83: G***; kibuzzard-6A80ED83
kibuzzard-6A80EDA5: G***; kibuzzard-6A80EDA5
kibuzzard-6A80EDE6: G***; kibuzzard-6A80EDE6
