Szymon423/Air-Quality-Sensor/(commit log)

2026-08-15 Finished layout of d70mm PCB
    [air-quality-sensor.kicad_pcb, air-quality-sensor.kicad_sch, bom.csv, designators.csv, positions.csv]
2026-10-19 Repo cleanup: gitignore, README, licenses, optimized renders
    [btm.stl, enclosure-test.3mf, top.stl]
